leandrosly/s16-companion/imagens/componentes/D_NQ_NP_2X_614847-MLB119121963469_102026-F-modulo-dac-pcm5102-i2s-estereo-conversor-audio-digital-decal-sup.jpg

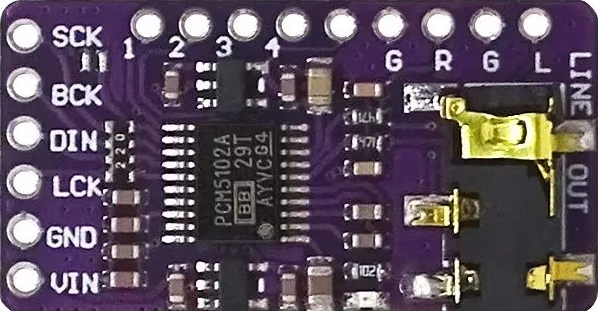
imagens/componentes/D_NQ_NP_2X_614847-MLB119121963469_102026-F-modulo-dac-pcm5102-i2s-estereo-conversor-audio-digital-decal-sup.jpg
