leandrosly/s16-companion/galeria_fotos/imagens/foto1.jpg

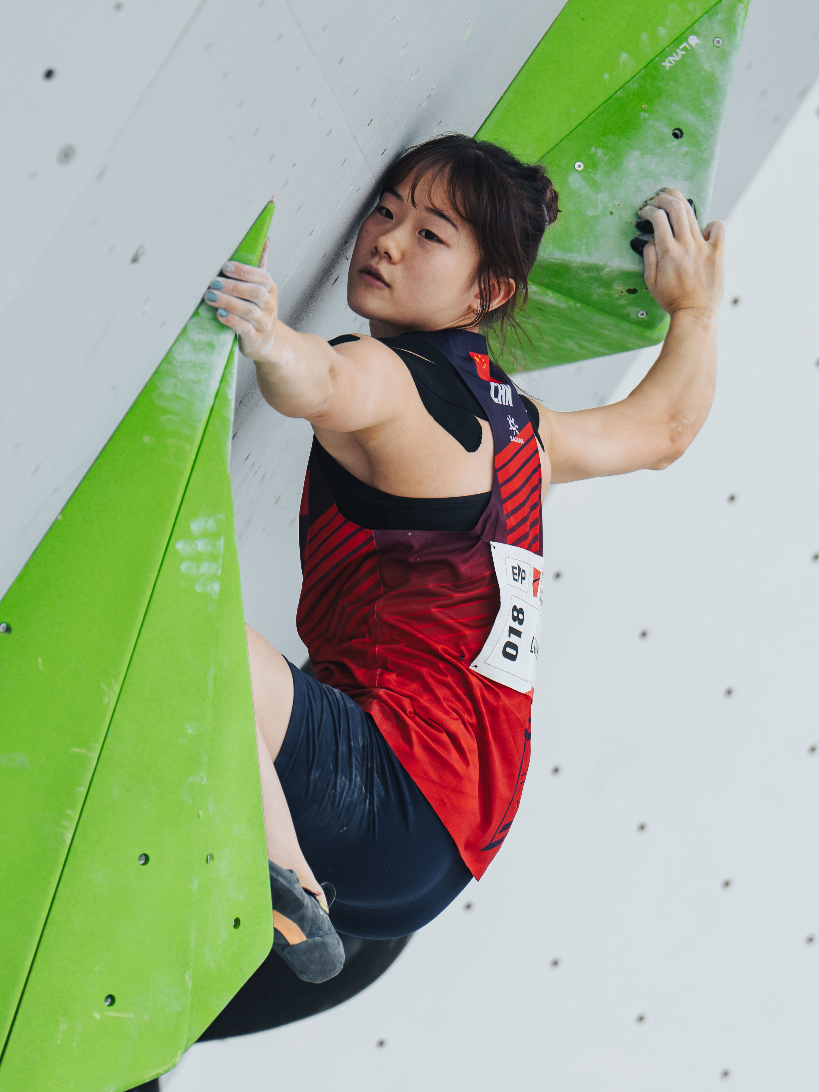
galeria_fotos/imagens/foto1.jpg
