leandrosly/s16-companion/galeria_fotos/imagens/foto2.jpg

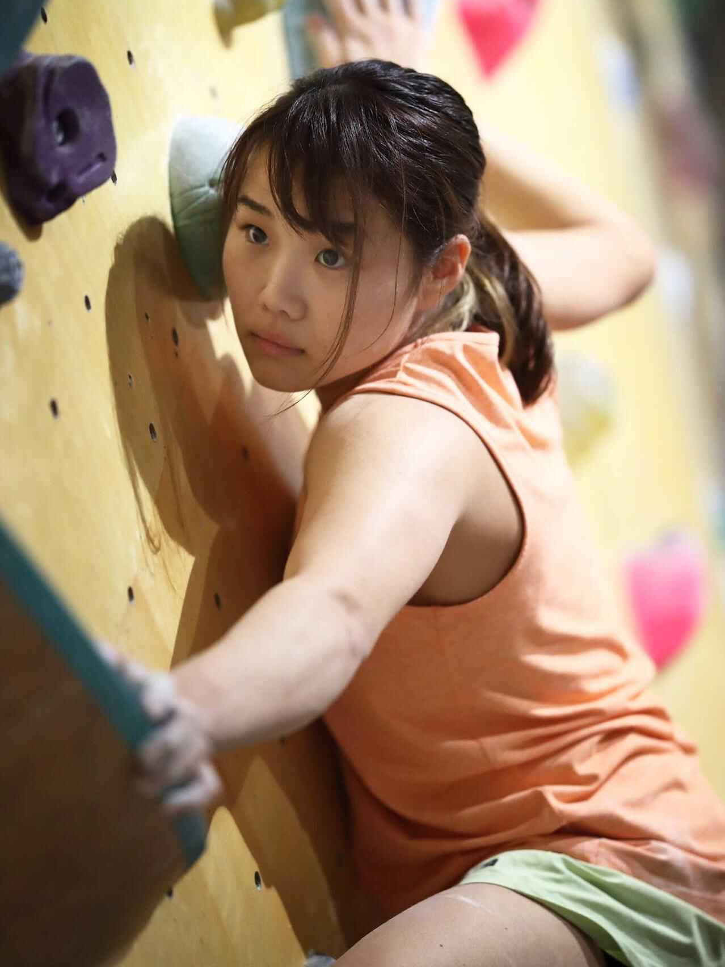
galeria_fotos/imagens/foto2.jpg
