leandrosly/s16-companion/galeria_fotos/imagens/foto3.jpg

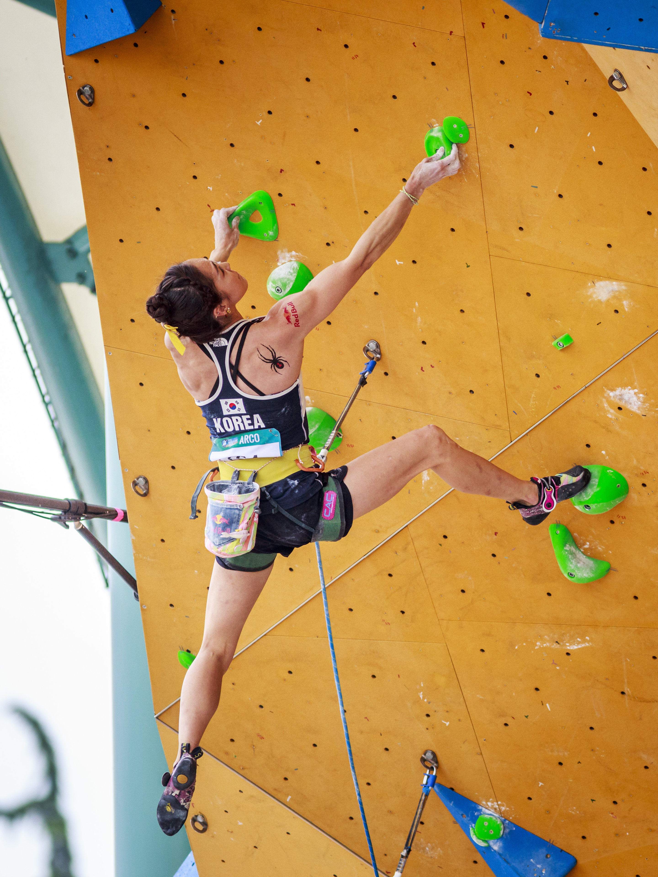
galeria_fotos/imagens/foto3.jpg
