leandrosly/s16-companion/galeria_fotos/imagens/foto4.jpg

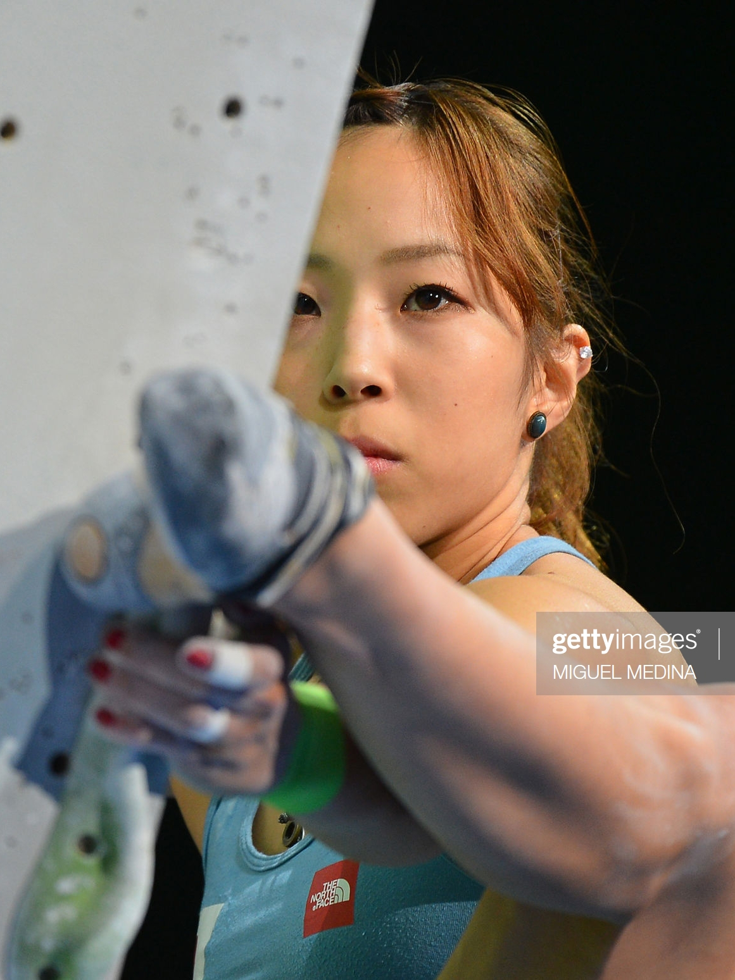
galeria_fotos/imagens/foto4.jpg
