leandrosly/s16-companion/galeria_fotos/imagens/foto5.jpg

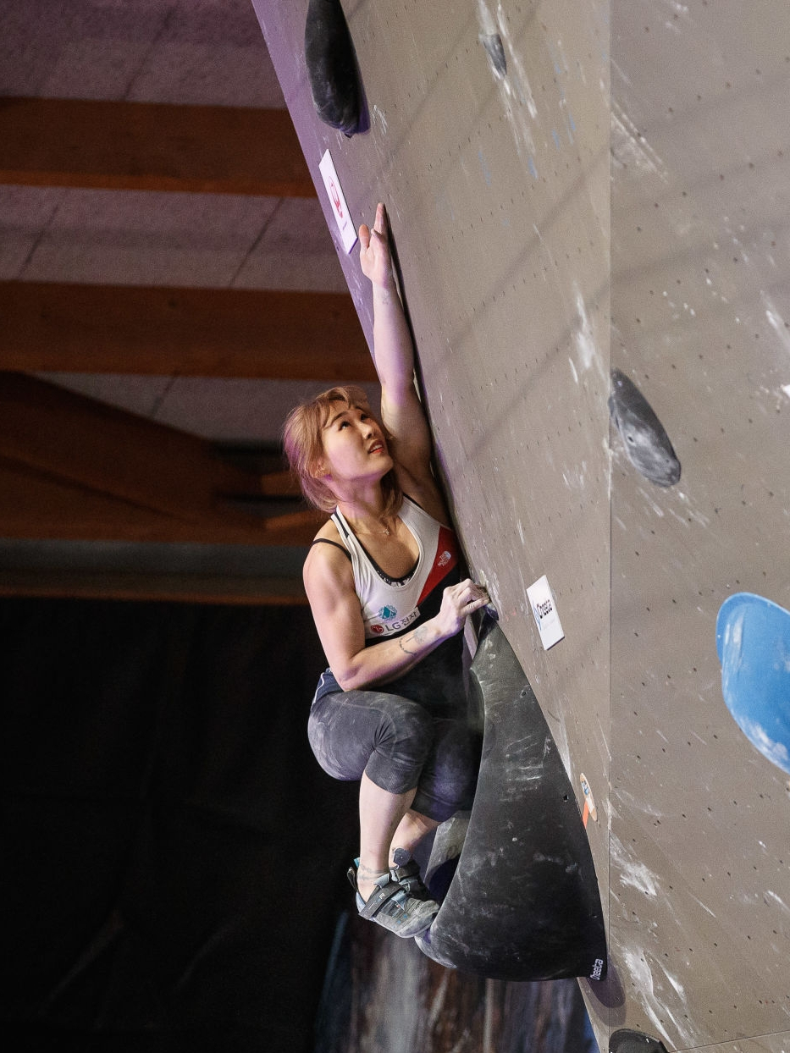
galeria_fotos/imagens/foto5.jpg
