leandrosly/s16-companion/galeria_fotos/imagens/foto6.jpg

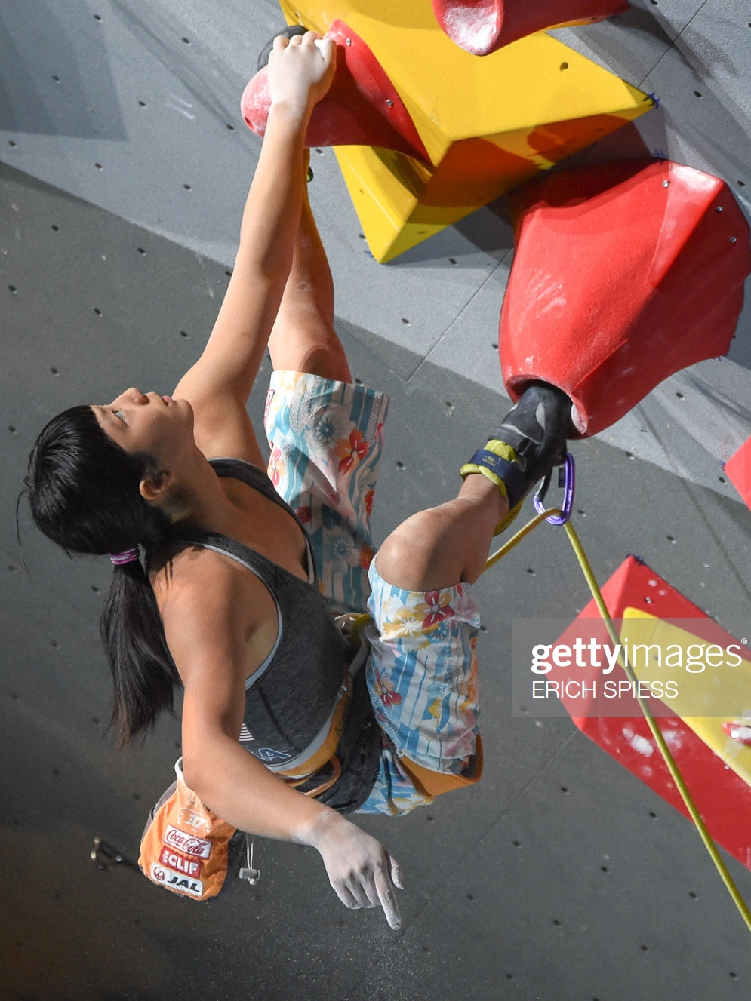
galeria_fotos/imagens/foto6.jpg
