leandrosly/s16-companion/imagens/fotos_placa_s16/PICA0004.jpg

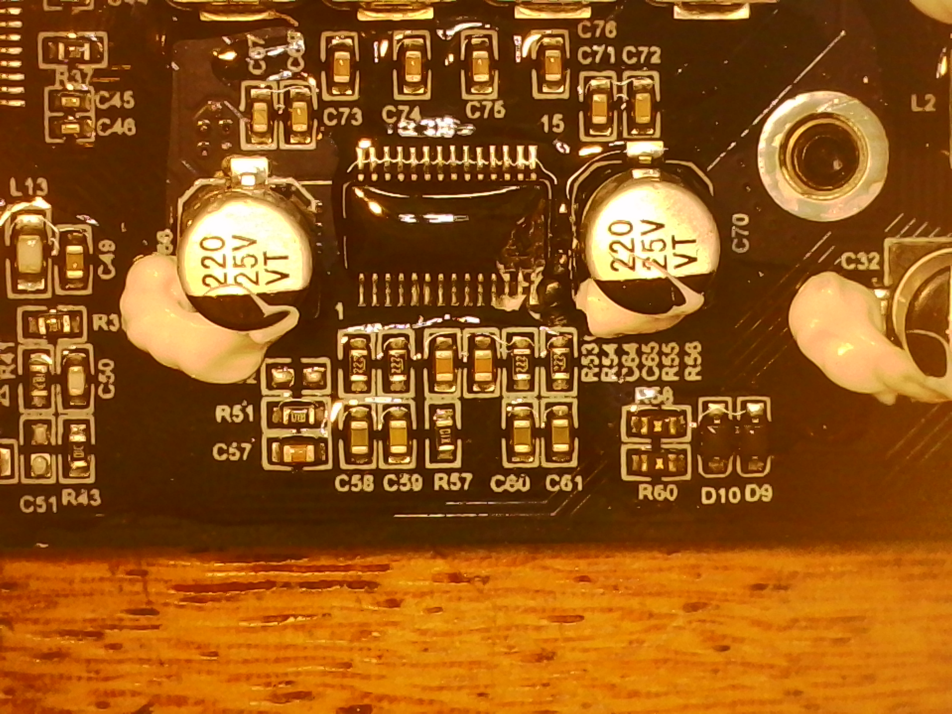
imagens/fotos_placa_s16/PICA0004.jpg
