leandrosly/s16-companion/imagens/fotos_placa_s16/PICA0006.jpg

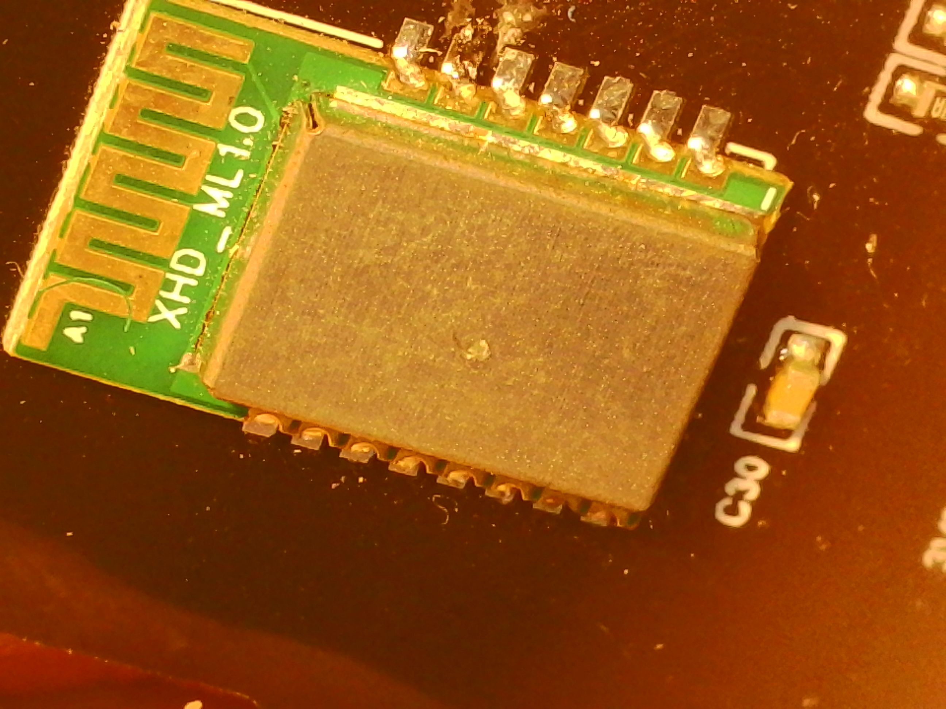
imagens/fotos_placa_s16/PICA0006.jpg
