leandrosly/s16-companion/imagens/fotos_placa_s16/PICA0007.jpg

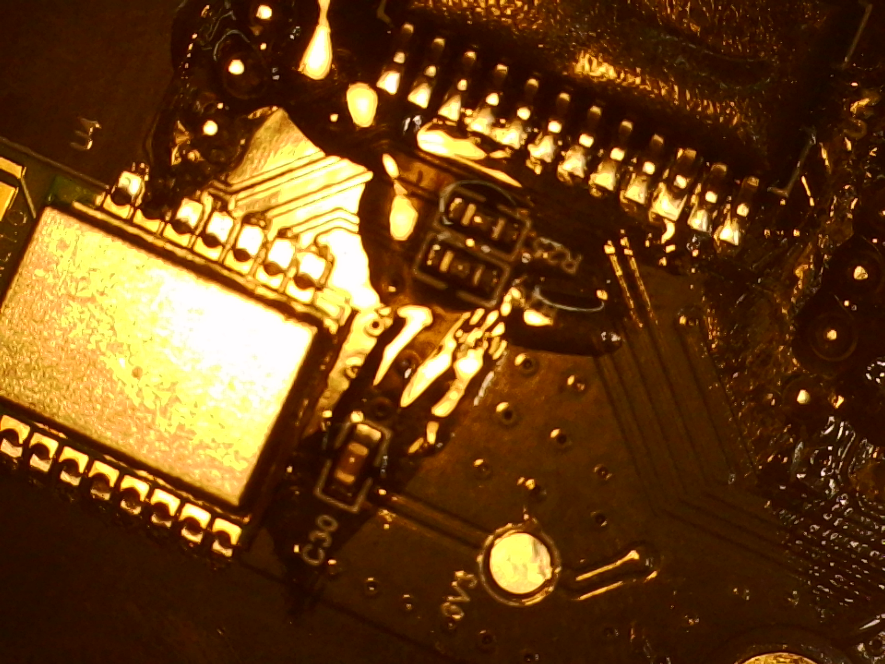
imagens/fotos_placa_s16/PICA0007.jpg
