leandrosly/s16-companion/imagens/fotos_placa_s16/PICA0008.jpg

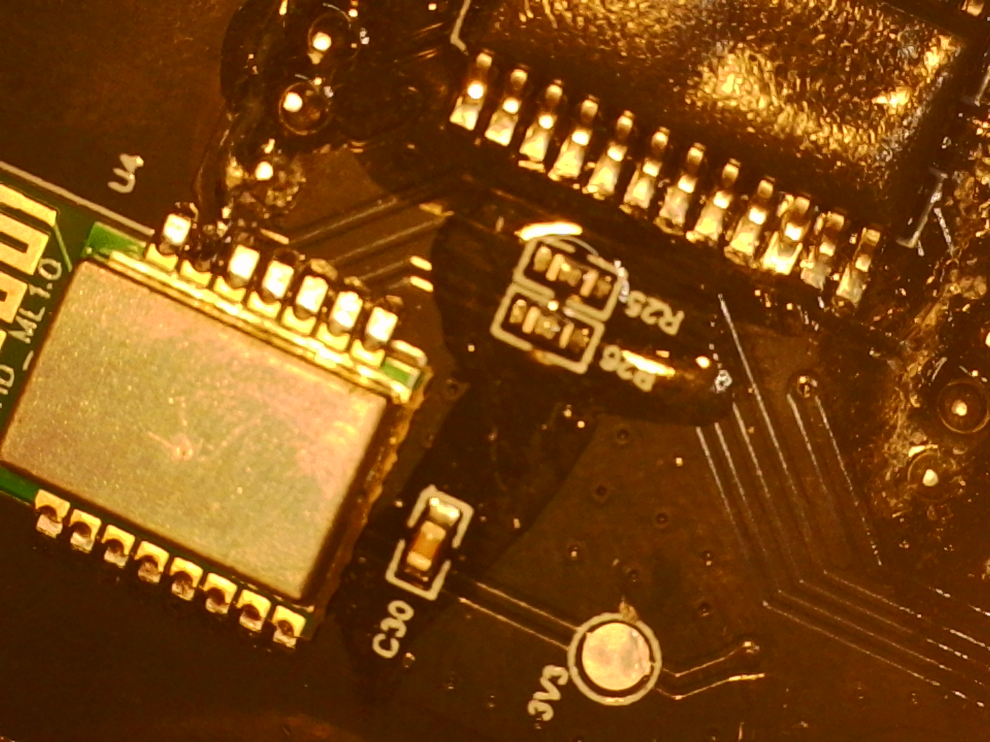
imagens/fotos_placa_s16/PICA0008.jpg
