leandrosly/s16-companion/imagens/componentes/D_NQ_NP_2X_686014-MLB119121433987_102026-F-modulo-dac-pcm5102-i2s-estereo-conversor-audio-digital.webp

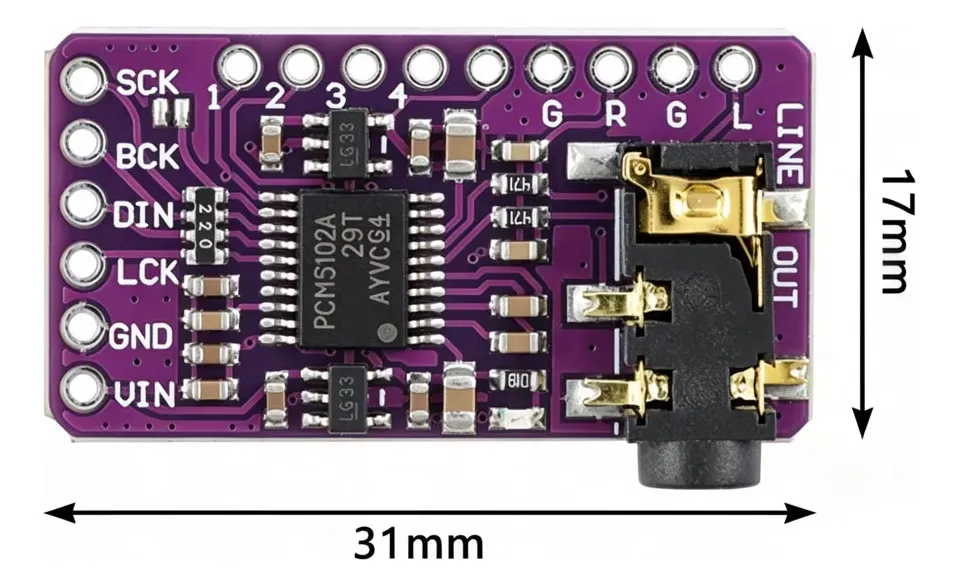
imagens/componentes/D_NQ_NP_2X_686014-MLB119121433987_102026-F-modulo-dac-pcm5102-i2s-estereo-conversor-audio-digital.webp
