leandrosly/s16-companion/imagens/componentes/D_NQ_NP_2X_740442-MLB73090768764_112023-F-par-de-modulos-rf-stx882-chip-super-heterodino-com-antenas-decal-inf.jpg

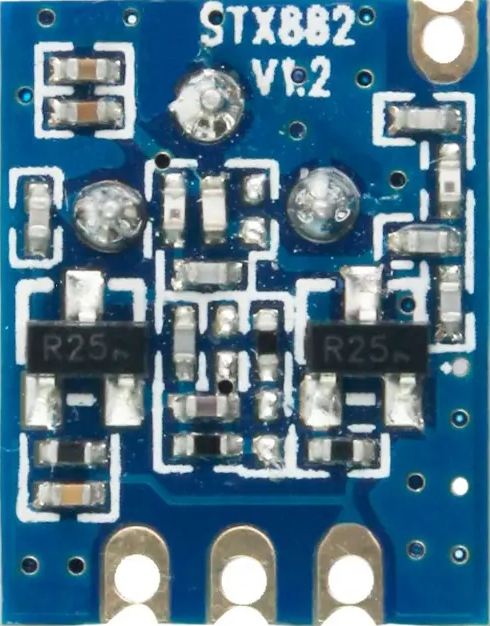
imagens/componentes/D_NQ_NP_2X_740442-MLB73090768764_112023-F-par-de-modulos-rf-stx882-chip-super-heterodino-com-antenas-decal-inf.jpg
