leandrosly/s16-companion/imagens/componentes/esp32-c3-super-mini-com-wifi-e-bluetooth-com-usb-c-decal-sup-decal-inf.jpg

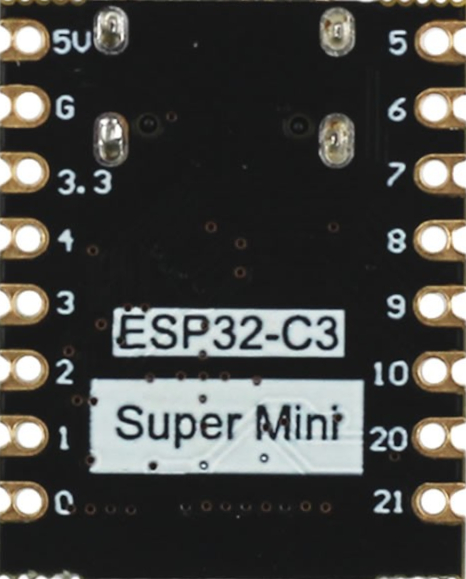
imagens/componentes/esp32-c3-super-mini-com-wifi-e-bluetooth-com-usb-c-decal-sup-decal-inf.jpg
