leandrosly/s16-companion/3d_case/Suporte.3mf

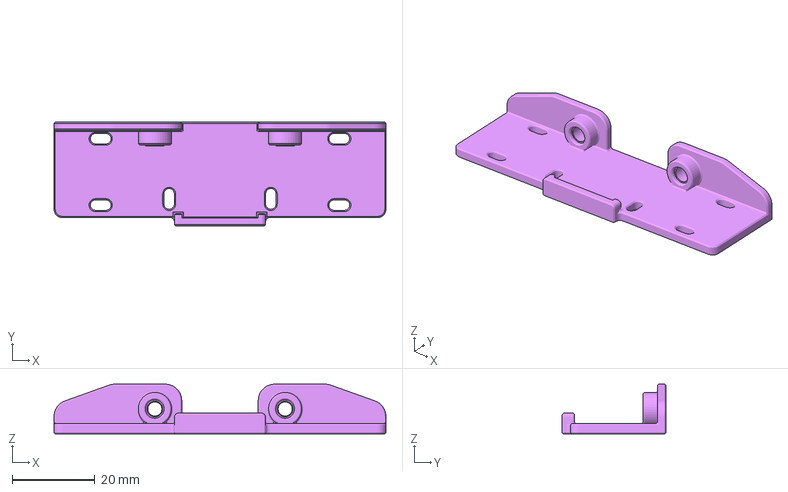
[picture p26: CAD file, 2026-11-10]
3d_case/Suporte.3mf
80.0 x 25.0 x 12.0 mm
