leandrosly/s16-companion/3d_case/Suporte ESP32 C3 no S16.step

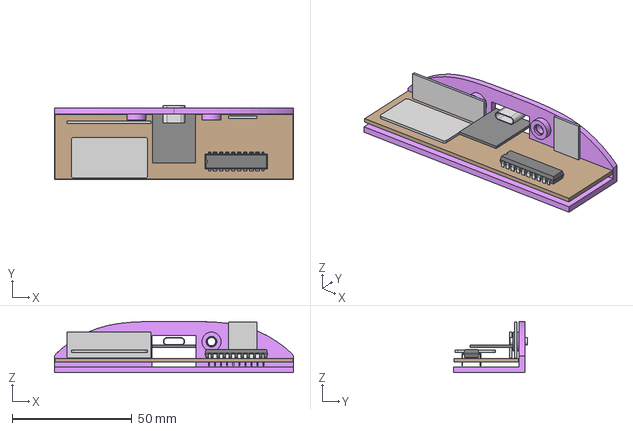
[picture p27: CAD file, 2026-11-10]
3d_case/Suporte ESP32 C3 no S16.step
100.0 x 31.0 x 21.5 mm
