leandrosly/s16-companion/3d_case/Espaço interno.3mf

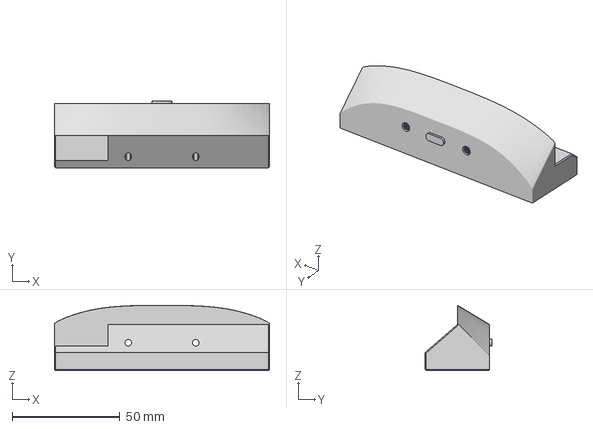
[picture p28: CAD file, 2026-11-10]
3d_case/Espaço interno.3mf
100.0 x 31.0 x 30.4 mm
