leandrosly/s16-companion/3d_case/S16 Companion.3mf

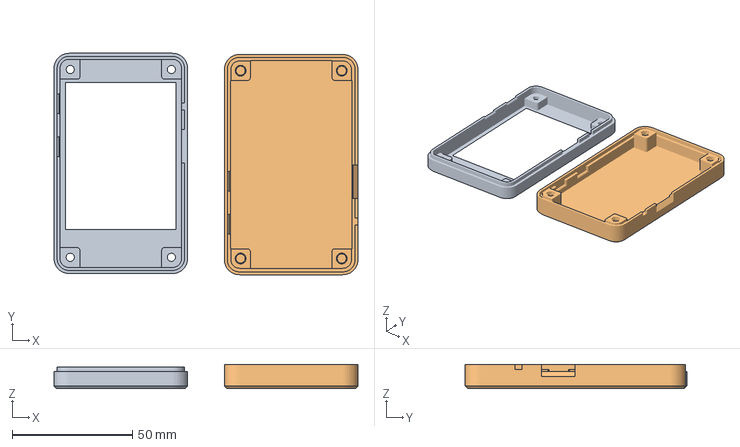
[picture p29: CAD file, 2026-10-17]
3d_case/S16 Companion.3mf
126.3 x 92.0 x 10.0 mm
