leandrosly/s16-companion/(list of files, cad)

Other CAD files:
3d_case/Suporte ESP32 C3 no S16 com pcb e módulos.3mf
3d_case/Suporte ESP32 C3 no S16.3mf
3d_case/Suporte ESP32 C3 no S16.f3d
