leandrosly/s16-companion/prints/print_001.bmp

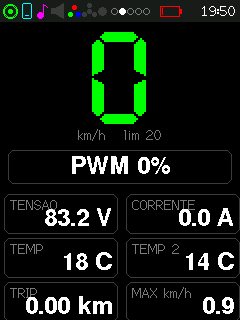
prints/print_001.bmp
