leandrosly/s16-companion/prints/print_002.bmp

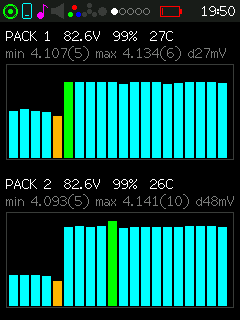
prints/print_002.bmp
