leandrosly/s16-companion/prints/print_004.bmp

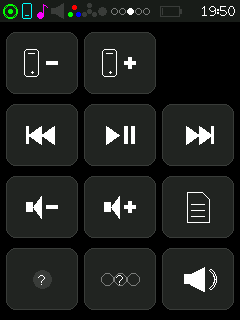
prints/print_004.bmp
