leandrosly/s16-companion/prints/print_005.bmp

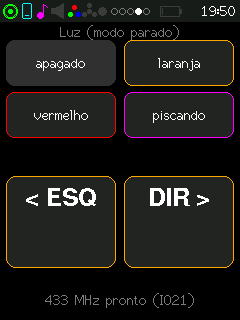
prints/print_005.bmp
