leandrosly/s16-companion/prints/print_006.bmp

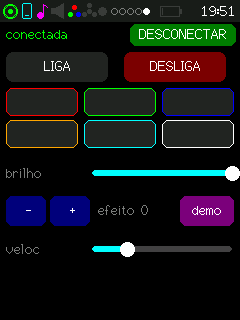
prints/print_006.bmp
