leandrosly/s16-companion/prints/print_007.bmp

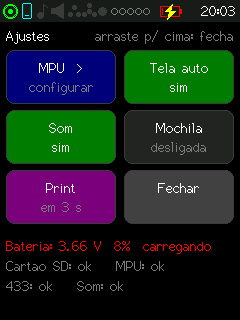
prints/print_007.bmp
