leandrosly/s16-companion/3d_case/Suporte ESP32 C3 no S16.pdf

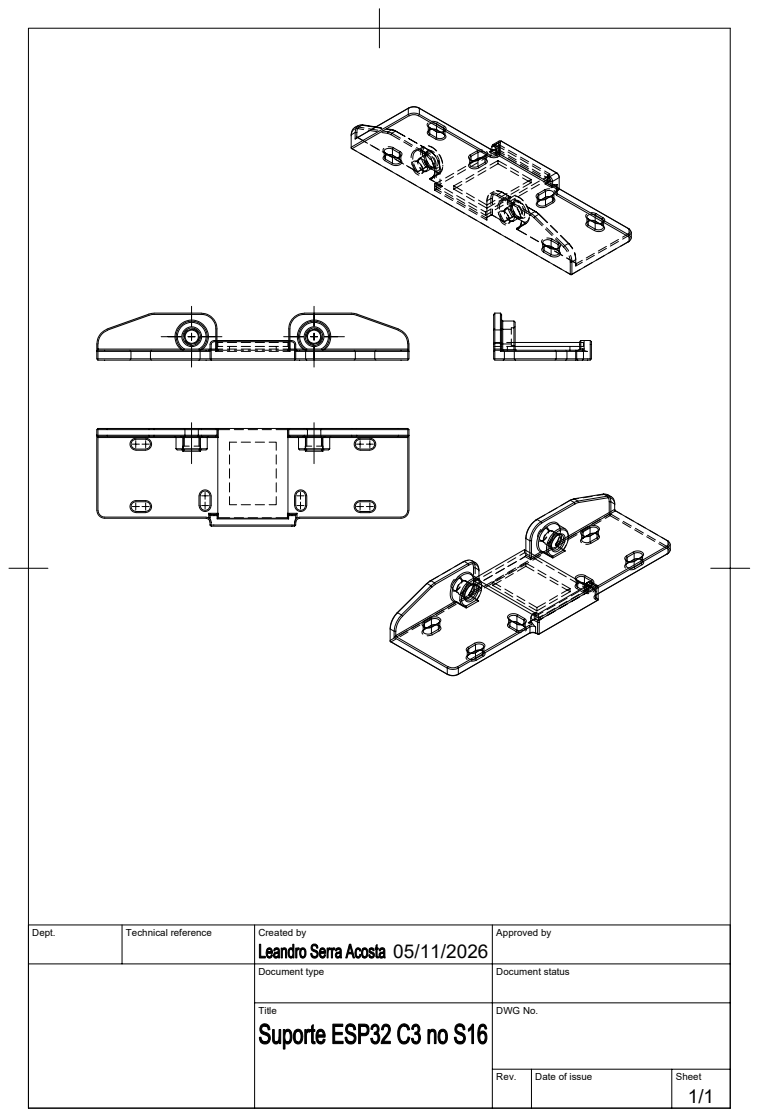
[picture p36: page 1]
Dept.; Technical reference; Created by; Approved by; Document type; Document status; Title; DWG No.; Rev.; Date of issue; Sheet
