leandrosly/s16-companion/pcb_kicad/S16_placa.kicad_pcb

## KiCad design pcb_kicad/S16_placa.kicad_pcb (2026-11-11)

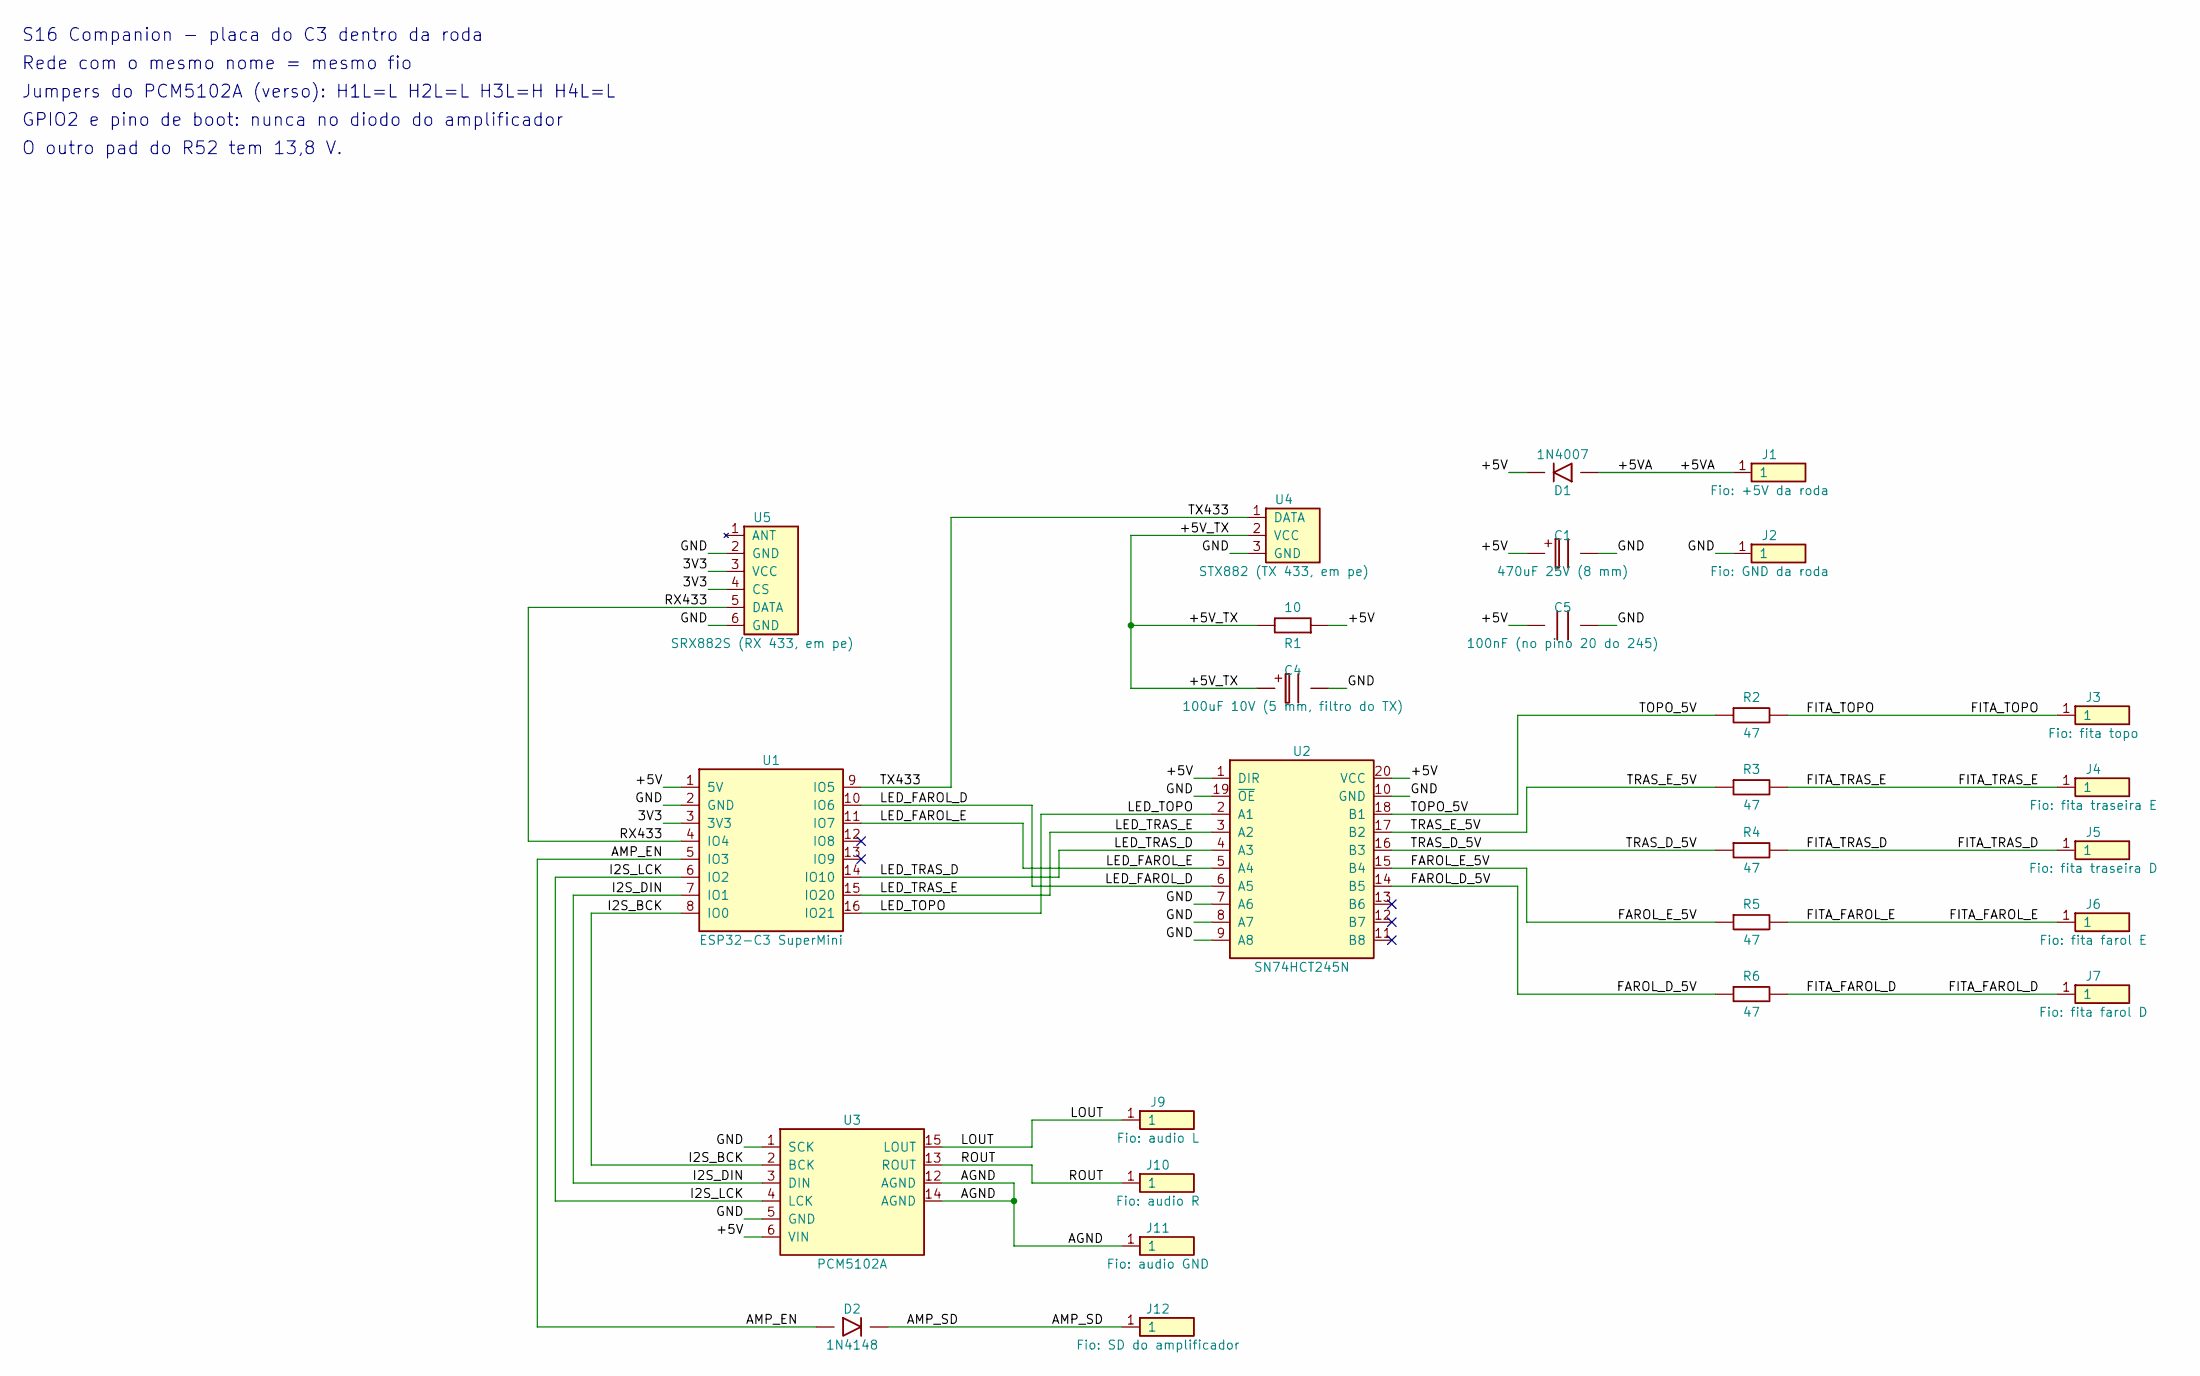
[picture p37: schematic S16_placa.kicad_sch, S16 Companion - placa do C3]

Parts:
C1: 470uF 25V (8 mm); CP_Radial_D8.0mm_P3.50mm
C4: 100uF 10V (5 mm, filtro do TX); CP_Radial_D5.0mm_P2.00mm
C5: 100nF (no pino 20 do 245); C_Disc_D5.0mm_W2.5mm_P5.00mm
D1: 1N4007; D_DO-41_SOD81_P7.62mm_Horizontal
D2: 1N4148; D_DO-35_SOD27_P7.62mm_Horizontal
J1: Fio: +5V da roda; TestPoint_THTPad_D2.5mm_Drill1.2mm
J2: Fio: GND da roda; TestPoint_THTPad_D2.5mm_Drill1.2mm
J3: Fio: fita topo; TestPoint_THTPad_D2.0mm_Drill1.0mm
J4: Fio: fita traseira E; TestPoint_THTPad_D2.0mm_Drill1.0mm
J5: Fio: fita traseira D; TestPoint_THTPad_D2.0mm_Drill1.0mm
J6: Fio: fita farol E; TestPoint_THTPad_D2.0mm_Drill1.0mm
J7: Fio: fita farol D; TestPoint_THTPad_D2.0mm_Drill1.0mm
J9: Fio: audio L; TestPoint_THTPad_D2.0mm_Drill1.0mm
J10: Fio: audio R; TestPoint_THTPad_D2.0mm_Drill1.0mm
J11: Fio: audio GND; TestPoint_THTPad_D2.0mm_Drill1.0mm
J12: Fio: SD do amplificador; TestPoint_THTPad_D2.0mm_Drill1.0mm
R1: 10; R_Axial_DIN0207_L6.3mm_D2.5mm_P7.62mm_Horizontal
R2, R3, R4, R5, R6: 47; R_Axial_DIN0207_L6.3mm_D2.5mm_P2.54mm_Vertical
U1: ESP32-C3 SuperMini; ESP32-C3_SuperMini
U2: SN74HCT245N; DIP-20_W7.62mm
U3: PCM5102A; PCM5102A_Modulo
U4: STX882 (TX 433, em pe); STX882_EmPe
U5: SRX882S (RX 433, em pe); SRX882S_EmPe

Connections:
/3V3: U1.3 (3V3), U5.3 (VCC), U5.4 (CS)
/+5V: C1.1, C5.1, D1.1, R1.1, U1.1 (5V), U2.1 (DIR), U2.20 (VCC), U3.6 (VIN)
/+5VA: D1.2, J1.1 (1_1)
/+5V_TX: C4.1, R1.2, U4.2 (VCC)
/AGND: J11.1 (1_1), U3.12 (AGND), U3.14 (AGND)
/AMP_EN: D2.2, U1.5 (IO3)
/AMP_SD: D2.1, J12.1 (1_1)
/FAROL_D_5V: R6.1, U2.14 (B5)
/FAROL_E_5V: R5.1, U2.15 (B4)
/FITA_FAROL_D: J7.1 (1_1), R6.2
/FITA_FAROL_E: J6.1 (1_1), R5.2
/FITA_TOPO: J3.1 (1_1), R2.2
/FITA_TRAS_D: J5.1 (1_1), R4.2
/FITA_TRAS_E: J4.1 (1_1), R3.2
/GND: C1.2, C4.2, C5.2, J2.1 (1_1), U1.2 (GND), U2.7 (A6), U2.8 (A7), U2.9 (A8), U2.10 (GND), U2.19 (~OE), U3.1 (SCK), U3.5 (GND), U4.3 (GND), U5.2 (GND), U5.6 (GND)
/I2S_BCK: U1.8 (IO0), U3.2 (BCK)
/I2S_DIN: U1.7 (IO1), U3.3 (DIN)
/I2S_LCK: U1.6 (IO2), U3.4 (LCK)
/LED_FAROL_D: U1.10 (IO6), U2.6 (A5)
/LED_FAROL_E: U1.11 (IO7), U2.5 (A4)
/LED_TOPO: U1.16 (IO21), U2.2 (A1)
/LED_TRAS_D: U1.14 (IO10), U2.4 (A3)
/LED_TRAS_E: U1.15 (IO20), U2.3 (A2)
/LOUT: J9.1 (1_1), U3.15 (LOUT)
/ROUT: J10.1 (1_1), U3.13 (ROUT)
/RX433: U1.4 (IO4), U5.5 (DATA)
/TOPO_5V: R2.1, U2.18 (B1)
/TRAS_D_5V: R4.1, U2.16 (B3)
/TRAS_E_5V: R3.1, U2.17 (B2)
/TX433: U1.9 (IO5), U4.1 (DATA)

Notes on the sheet:
Jumpers do PCM5102A (verso): H1L=L H2L=L H3L=H H4L=L
GPIO2 e pino de boot: nunca no diodo do amplificador
S16 Companion - placa do C3 dentro da roda
O outro pad do R52 tem 13,8 V.
Rede com o mesmo nome = mesmo fio

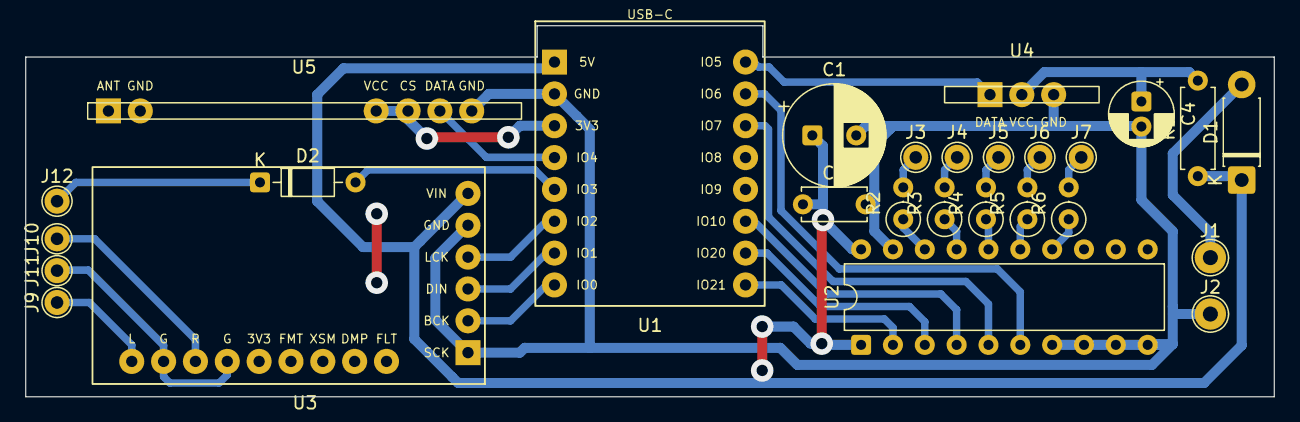
[picture p38: board S16_placa.kicad_pcb from above]

Board: 2 copper layers, 99.6 x 29.6 mm, 27 parts (0 on the bottom side), 30 nets.
