leandrosly/s16-companion/esquema_placa/projeto_kicad/projeto_kicad.kicad_sch

## KiCad design esquema_placa/projeto_kicad/projeto_kicad.kicad_sch (2026-11-10)

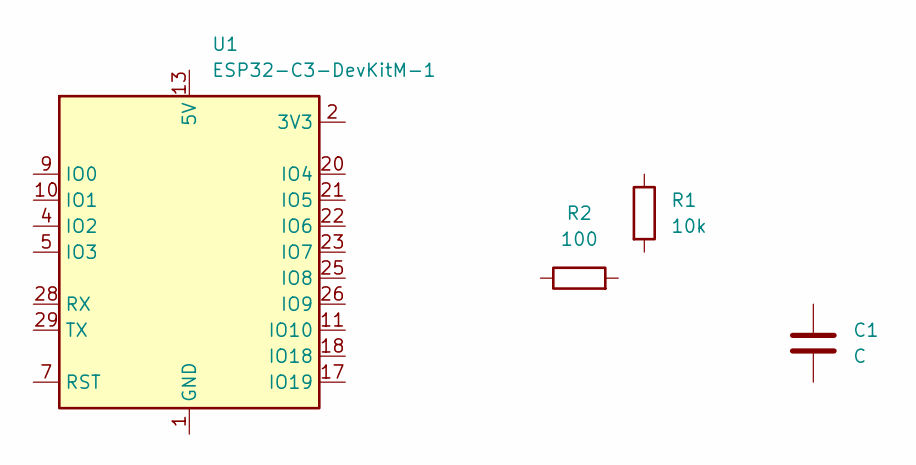
[picture p39: schematic projeto_kicad.kicad_sch]

Parts:
C1: C
R1: 10k
R2: 100
U1: ESP32-C3-DevKitM-1

Connections:
unnamed: U1.1 (GND), U1.6 (GND), U1.8 (GND), U1.12 (GND), U1.15 (GND), U1.16 (GND), U1.19 (GND), U1.24 (GND), U1.27 (GND), U1.30 (GND)
unnamed: U1.2 (3V3), U1.3 (3V3)
unnamed: U1.13 (5V), U1.14 (5V)
