leandrosly/s16-companion/app_android/app/src/main/java/Telas.kt

package systems.leandro.s16

// Telas do app (Jetpack Compose): barra com a conexao no topo e as paginas embaixo, que trocam tocando
// nos botoes ou arrastando para o lado:
//   com o C3:              Roda, Piscas, Fitas, Buzina, Sons
//   direto na roda:        Roda, Sons
//   sem conexao:           Sons (com a simulacao de velocidade)

import androidx.compose.animation.core.RepeatMode
import androidx.compose.animation.core.animateFloat
import androidx.compose.animation.core.infiniteRepeatable
import androidx.compose.animation.core.rememberInfiniteTransition
import androidx.compose.animation.core.tween
import androidx.compose.foundation.Canvas
import androidx.compose.foundation.background
import androidx.compose.foundation.border
import androidx.compose.foundation.clickable
import androidx.compose.foundation.gestures.detectTapGestures
import androidx.compose.foundation.layout.Spacer
import androidx.compose.foundation.layout.Arrangement
import androidx.compose.foundation.layout.Box
import androidx.compose.foundation.layout.PaddingValues
import androidx.compose.foundation.pager.HorizontalPager
import androidx.compose.foundation.pager.rememberPagerState
import androidx.compose.foundation.layout.Column
import androidx.compose.foundation.layout.ColumnScope
import androidx.compose.foundation.layout.Row
import androidx.compose.foundation.layout.fillMaxSize
import androidx.compose.foundation.layout.fillMaxWidth
import androidx.compose.foundation.layout.height
import androidx.compose.foundation.layout.padding
import androidx.compose.foundation.layout.safeDrawingPadding
import androidx.compose.foundation.layout.size
import androidx.compose.foundation.rememberScrollState
import androidx.compose.foundation.shape.CircleShape
import androidx.compose.foundation.shape.RoundedCornerShape
import androidx.compose.foundation.verticalScroll
import androidx.compose.material3.Button
import androidx.compose.material3.ButtonDefaults
import androidx.compose.material3.Card
import androidx.compose.material3.CardDefaults
import androidx.compose.material3.DropdownMenu
import androidx.compose.material3.DropdownMenuItem
import androidx.compose.material3.MaterialTheme
import androidx.compose.material3.OutlinedButton
import androidx.compose.material3.Slider
import androidx.compose.material3.Surface
import androidx.compose.material3.Switch
import androidx.compose.material3.Text
import androidx.compose.material3.darkColorScheme
import androidx.compose.runtime.Composable
import androidx.compose.runtime.LaunchedEffect
import androidx.compose.runtime.collectAsState
import androidx.compose.runtime.getValue
import androidx.compose.runtime.mutableFloatStateOf
import androidx.compose.runtime.mutableIntStateOf
import androidx.compose.runtime.mutableStateOf
import androidx.compose.runtime.remember
import androidx.compose.runtime.rememberUpdatedState
import androidx.compose.runtime.rememberCoroutineScope
import androidx.compose.runtime.saveable.rememberSaveable
import androidx.compose.runtime.setValue
import androidx.compose.ui.Alignment
import androidx.compose.ui.Modifier
import androidx.compose.ui.draw.alpha
import androidx.compose.ui.draw.clip
import androidx.compose.ui.geometry.Offset
import androidx.compose.ui.graphics.Path
import androidx.compose.ui.graphics.StrokeCap
import androidx.compose.ui.graphics.StrokeJoin
import androidx.compose.ui.graphics.drawscope.Stroke
import androidx.compose.ui.graphics.Color
import androidx.compose.ui.input.pointer.pointerInput
import androidx.compose.ui.platform.LocalContext
import androidx.compose.ui.text.font.FontWeight
import androidx.compose.ui.unit.dp
import androidx.compose.ui.unit.sp
import androidx.compose.ui.window.Dialog
import kotlinx.coroutines.launch
import kotlin.math.roundToInt

// ---------------- cores ----------------
private val Laranja = Color(0xFFF2A23A)
private val Fundo = Color(0xFF14171B)
private val Painel = Color(0xFF1D2126)
private val Texto = Color(0xFFE5E8EC)
private val Apagado = Color(0xFF8D97A3)
private val Vermelho = Color(0xFFFF5B4B)

private val esquema = darkColorScheme(
    primary = Laranja, onPrimary = Color(0xFF1B1200),
    secondary = Color(0xFF4FC3CC),
    background = Fundo, onBackground = Texto,
    surface = Painel, onSurface = Texto,
)

// mesma paleta do C3 (LED_PAL no ponte_c3.ino), na mesma ordem
private val PALETA = listOf(
    Color(255, 0, 0), Color(255, 90, 0), Color(255, 200, 0), Color(0, 255, 0),
    Color(0, 255, 200), Color(0, 0, 255), Color(0x4E, 0, 0x8F), Color(200, 200, 200),
)
private val NOMES_COR = listOf("vermelho", "laranja", "amarelo", "verde", "ciano", "azul", "violeta", "branco")
private val MODOS_FITA = listOf("Apagadas", "Cor fixa", "Respirando", "Arco-íris", "Automático")
private val LUZES = listOf("Apagadas", "Laranja", "Vermelhas", "Piscando")

// buzina externa: mesmos codigos do display (BX_CMD)
private val BUZINA = listOf(
    "Volume −" to 0xCC, "Volume +" to 0x99,
    "◀ Som" to 0x66, "Som ▶" to 0xFF,
    "Alarme liga" to 0x55, "Alarme desliga" to 0x33,
)

// ---------------- estrutura ----------------
@Composable
fun App(
    link: C3Link,
    macSalvo: String?,
    temPermissao: Boolean,
    btLigado: Boolean,
    pedirPermissao: () -> Unit,
    salvarMac: (String) -> Unit,
) {
    MaterialTheme(colorScheme = esquema) {
        Surface(Modifier.fillMaxSize(), color = Fundo) {
            Column(
                Modifier.fillMaxSize().safeDrawingPadding().padding(horizontal = 16.dp, vertical = 12.dp),
                verticalArrangement = Arrangement.spacedBy(12.dp),
            ) {
                if (!temPermissao || !btLigado) Text("S16 Companion", fontSize = 22.sp, fontWeight = FontWeight.Bold, color = Texto)
                when {
                    !temPermissao -> Aviso("O app precisa da permissão de Bluetooth para achar o C3 na roda.", "Permitir", pedirPermissao)
                    !btLigado -> Aviso("O Bluetooth está desligado. Ligue e volte para o app.", null) {}
                    else -> {
                        BarraTopo(link, macSalvo, salvarMac)
                        Principal(link)                          // (dentro da Column: ocupa o resto da tela)
                    }
                }
            }
        }
    }
}

@Composable
private fun ColumnScope.Principal(link: C3Link) {
    val con by link.conexao.collectAsState()
    val est by link.estado.collectAsState()
    val direto by link.direto.collectAsState()

    val comC3 = (con == Conexao.CONECTADO && est.recebido) || con == Conexao.DEMO
    val naRoda = con == Conexao.CONECTADO && direto
    val paginas = when {
        comC3 -> listOf("Roda", "Piscas", "Fitas", "Buzina", "Sons")
        naRoda -> listOf("Roda", "Sons")
        else -> listOf("Sons")
    }
    run {
        val pager = rememberPagerState(pageCount = { paginas.size })
        val escopo = rememberCoroutineScope()
        Row(horizontalArrangement = Arrangement.spacedBy(6.dp)) {
            paginas.forEachIndexed { i, nome ->
                Botao(nome, Modifier.weight(1f), selecionado = pager.currentPage == i) {
                    escopo.launch { pager.animateScrollToPage(i) }
                }
            }
        }
        HorizontalPager(
            state = pager,
            modifier = Modifier.fillMaxWidth().weight(1f),
            pageSpacing = 16.dp,
            verticalAlignment = Alignment.Top,
        ) { pagina ->
            Column(
                Modifier.fillMaxSize().verticalScroll(rememberScrollState()),
                verticalArrangement = Arrangement.spacedBy(12.dp),
            ) {
                when (paginas.getOrNull(pagina)) {
                    "Roda" -> TelaRoda(link, direto)
                    "Piscas" -> TelaPiscas(link, est)
                    "Fitas" -> TelaFitas(link, est)
                    "Buzina" -> TelaBuzina(link)
                    "Sons" -> TelaSons()
                }
            }
        }
    }
}

// ---------------- barra do topo: nome, estado da conexao e o botao do Bluetooth ----------------
// Icone do Bluetooth:  cinza = desconectado (toque: conecta)  ·  piscando = tentando (toque: para)
//                      colorido = conectado (toque: menu com detalhes, trocar e desconectar)
// O "+" ao lado (so desconectado) abre a lista para escolher o C3 ou a roda.
@Composable
private fun BarraTopo(link: C3Link, macSalvo: String?, salvarMac: (String) -> Unit) {
    val con by link.conexao.collectAsState()
    val est by link.estado.collectAsState()
    val direto by link.direto.collectAsState()
    var lista by remember { mutableStateOf(false) }
    var menu by remember { mutableStateOf(false) }
    val tentando = con == Conexao.CONECTANDO || (con == Conexao.DESCONECTADO && link.querendoConexao)

    val estado = when {
        con == Conexao.DEMO -> "demonstração"
        con == Conexao.CONECTADO && direto -> "na roda (sem C3)"
        con == Conexao.CONECTADO && est.recebido -> if (est.radioOk) "conectado" else "conectado · rádio 433 com problema"
        con == Conexao.CONECTADO -> "esperando resposta..."
        tentando -> "conectando..."
        con == Conexao.PROCURANDO -> "procurando..."
        macSalvo == null -> "toque no + para achar a roda"
        else -> "desconectado"
    }
    val corEstado = if (con == Conexao.CONECTADO && est.recebido && !est.radioOk) Laranja else Apagado

    Row(Modifier.fillMaxWidth(), verticalAlignment = Alignment.CenterVertically) {
        Column(Modifier.weight(1f)) {
            Text("S16 Companion", fontSize = 22.sp, fontWeight = FontWeight.Bold, color = Texto, maxLines = 1)
            Text(estado, fontSize = 13.sp, color = corEstado, maxLines = 1)
        }
        if (con == Conexao.DESCONECTADO && !tentando || con == Conexao.PROCURANDO) {
            IconeRedondo(Modifier.padding(end = 8.dp), ativo = false, onClick = { lista = true }) { cor -> DesenhoMais(cor) }
        }
        Box {
            val alfa = if (tentando) {
                val pisca = rememberInfiniteTransition(label = "pisca")
                pisca.animateFloat(
                    initialValue = 1f, targetValue = 0.25f,
                    animationSpec = infiniteRepeatable(tween(600), RepeatMode.Reverse), label = "alfa",
                ).value
            } else 1f
            val ativo = con == Conexao.CONECTADO || con == Conexao.DEMO || tentando
            IconeRedondo(Modifier.alpha(alfa), ativo = ativo, onClick = {
                when {
                    con == Conexao.CONECTADO || con == Conexao.DEMO -> menu = true
                    tentando -> link.desconectar()                                // para de tentar
                    macSalvo != null -> link.conectar(macSalvo)
                    else -> lista = true
                }
            }) { cor -> DesenhoBluetooth(cor) }
            DropdownMenu(expanded = menu, onDismissRequest = { menu = false }) {
                val info = when {
                    con == Conexao.DEMO -> "Demonstração: nada é enviado de verdade."
                    direto -> "Direto na roda: dados e sons funcionam; piscas e fitas precisam do C3."
                    else -> "C3 · rádio 433 ${if (est.radioOk) "ok" else "com problema"} · apps no C3: ${est.apps}"
                }
                Text(info, Modifier.padding(horizontal = 16.dp, vertical = 8.dp), fontSize = 13.sp, color = Apagado)
                if (con == Conexao.DEMO) {
                    DropdownMenuItem(text = { Text("Sair da demonstração") }, onClick = { menu = false; link.sairDemo() })
                } else {
                    DropdownMenuItem(text = { Text("Trocar de roda / C3") }, onClick = { menu = false; link.desconectar(); lista = true })
                    DropdownMenuItem(text = { Text("Desconectar") }, onClick = { menu = false; link.desconectar() })
                }
            }
        }
    }
    if (lista) SeletorConexao(link, salvarMac) { lista = false }
}

/** Janela com a busca: lista o C3 e a roda que aparecerem. */
@Composable
private fun SeletorConexao(link: C3Link, salvarMac: (String) -> Unit, fechar: () -> Unit) {
    val achados by link.achados.collectAsState()
    val con by link.conexao.collectAsState()
    var buscou by remember { mutableStateOf(false) }
    LaunchedEffect(con) { if (!buscou && con == Conexao.DESCONECTADO) { buscou = true; link.procurar() } }
    val sair = { link.pararBusca(); fechar() }
    Dialog(onDismissRequest = sair) {
        Card(colors = CardDefaults.cardColors(containerColor = Painel), modifier = Modifier.fillMaxWidth()) {
            Column(Modifier.fillMaxWidth().padding(16.dp), verticalArrangement = Arrangement.spacedBy(10.dp)) {
                Text("Conectar", fontSize = 20.sp, fontWeight = FontWeight.Bold, color = Texto)
                Text(
                    if (con == Conexao.PROCURANDO) "Procurando... ligue a roda: aparece o C3 (com o nome da roda, KS-...) ou a própria roda."
                    else "Busca parada.",
                    color = Apagado, fontSize = 13.sp,
                )
                achados.forEach { a ->
                    val ehRoda = a.mac.equals(MAC_RODA, ignoreCase = true)
                    Row(
                        Modifier.fillMaxWidth()
                            .clip(RoundedCornerShape(8.dp))
                            .background(Fundo)
                            .clickable { salvarMac(a.mac); link.conectar(a.mac); fechar() }
                            .padding(12.dp),
                        verticalAlignment = Alignment.CenterVertically,
                    ) {
                        Column(Modifier.weight(1f)) {
                            Text(a.nome, color = Texto)
                            Text(
                                a.mac + if (ehRoda) "  ·  a roda em si (direto, sem o C3)" else "",
                                fontSize = 12.sp, color = Apagado,
                            )
                        }
                        Text("${a.rssi} dBm", fontSize = 12.sp, color = Apagado)
                    }
                }
                Row(Modifier.fillMaxWidth(), verticalAlignment = Alignment.CenterVertically) {
                    Text(
                        "Demonstração",
                        Modifier.clickable { link.pararBusca(); link.entrarDemo(); fechar() }.padding(vertical = 8.dp),
                        color = Laranja, fontSize = 14.sp,
                    )
                    Spacer(Modifier.weight(1f))
                    if (con != Conexao.PROCURANDO) OutlinedButton(onClick = { link.procurar() }) { Text("Procurar de novo") }
                    else OutlinedButton(onClick = sair) { Text("Fechar") }
                }
            }
        }
    }
}

@Composable
private fun IconeRedondo(modifier: Modifier, ativo: Boolean, onClick: () -> Unit, desenho: @Composable (Color) -> Unit) {
    Box(
        modifier
            .size(44.dp)
            .clip(CircleShape)
            .background(if (ativo) Laranja else Painel)
            .clickable(onClick = onClick),
        contentAlignment = Alignment.Center,
    ) { desenho(if (ativo) Color(0xFF1B1200) else Apagado) }
}

/** O simbolo do Bluetooth (a runa), desenhado na mao para nao depender da biblioteca de icones. */
@Composable
private fun DesenhoBluetooth(cor: Color) {
    Canvas(Modifier.size(22.dp)) {
        val w = size.width; val h = size.height
        val p = Path().apply {
            moveTo(w * 0.28f, h * 0.30f)
            lineTo(w * 0.72f, h * 0.70f)
            lineTo(w * 0.50f, h * 0.90f)
            lineTo(w * 0.50f, h * 0.10f)
            lineTo(w * 0.72f, h * 0.30f)
            lineTo(w * 0.28f, h * 0.70f)
        }
        drawPath(p, cor, style = Stroke(width = w * 0.10f, cap = StrokeCap.Round, join = StrokeJoin.Round))
    }
}

@Composable
private fun DesenhoMais(cor: Color) {
    Canvas(Modifier.size(18.dp)) {
        val w = size.width; val h = size.height; val e = w * 0.12f
        drawLine(cor, Offset(w / 2, 0f), Offset(w / 2, h), strokeWidth = e, cap = StrokeCap.Round)
        drawLine(cor, Offset(0f, h / 2), Offset(w, h / 2), strokeWidth = e, cap = StrokeCap.Round)
    }
}

// ---------------- dados e comandos da roda ----------------
@Composable
private fun TelaRoda(link: C3Link, direto: Boolean) {
    val r by link.roda.collectAsState()
    val temDados = r.quando != 0L && System.currentTimeMillis() - r.quando < 3_000
    Secao("Roda") {
        if (!temDados) {
            Text("Sem dados da roda ainda.", color = Apagado)
        } else {
            Row(verticalAlignment = Alignment.Bottom) {
                Text("%.1f".format(r.velocidade), fontSize = 56.sp, fontWeight = FontWeight.Bold, color = Texto)
                Text("  km/h", fontSize = 18.sp, color = Apagado, modifier = Modifier.padding(bottom = 10.dp))
            }
            val corBat = when {
                r.bateria > 40 -> Texto
                r.bateria > 15 -> Laranja
                else -> Vermelho
            }
            val dados = listOf(
                // (o "%" da bateria fica FORA do format: dentro dele, "% ·" e lido como codigo de formatacao)
                Triple("Bateria", "${r.bateria}%" + (if (r.bateriaPeloBms) "" else " (≈)") + " · " + "%.1f V".format(r.tensao), corBat),
                Triple("Corrente", "%.1f A".format(r.corrente), Texto),
                Triple("Temperatura", "%.0f °C".format(r.temperatura), Texto),
                Triple("PWM", if (r.pwm >= 0) "${r.pwm}%" else "—", if (r.pwm >= 80) Vermelho else Texto),
                Triple("Viagem", "%.1f km".format(r.tripKm), Texto),
                Triple("Máxima", "%.1f km/h".format(r.maxima), Texto),
            )
            dados.chunked(2).forEach { par ->
                Row(Modifier.fillMaxWidth()) {
                    par.forEach { (rotulo, valor, cor) ->
                        Column(Modifier.weight(1f)) {
                            Text(rotulo, fontSize = 12.sp, color = Apagado)
                            Text(valor, fontSize = 18.sp, color = cor, fontWeight = FontWeight.SemiBold)
                        }
                    }
                }
            }
        }
    }
    Secao("Comandos da roda") {
        BotaoGrande("Buzina da roda", Modifier.fillMaxWidth(), selecionado = true) { link.enviarRoda(0x88) }
        Text("Volume dos alto-falantes", color = Apagado, fontSize = 13.sp)
        Row(horizontalArrangement = Arrangement.spacedBy(8.dp)) {
            Botao("Volume −", Modifier.weight(1f)) { link.enviarRoda(0x95, 0, 0xFF) }
            Botao("Volume +", Modifier.weight(1f)) { link.enviarRoda(0x95, 0xFF, 0) }
        }
        Text("Farol", color = Apagado, fontSize = 13.sp)
        Row(horizontalArrangement = Arrangement.spacedBy(8.dp)) {
            Botao("Liga", Modifier.weight(1f)) { link.enviarRoda(0x73, 0x12) }
            Botao("Desliga", Modifier.weight(1f)) { link.enviarRoda(0x73, 0x13) }
            Botao("Auto", Modifier.weight(1f)) { link.enviarRoda(0x73, 0x14) }
        }
    }
    Secao("Notificação") {
        val prefs = LocalContext.current.getSharedPreferences("s16", android.content.Context.MODE_PRIVATE)
        var qual by remember { mutableStateOf(prefs.getString(ConexaoService.PREF_BUZINA, "roda") ?: "roda") }
        Text("Botão \"Buzina\" da notificação toca:", color = Apagado, fontSize = 13.sp)
        Row(horizontalArrangement = Arrangement.spacedBy(8.dp)) {
            val opcoes = if (direto) listOf("roda" to "Da roda", "celular" to "Do celular")
                         else listOf("roda" to "Da roda", "externa" to "Externa", "celular" to "Do celular")
            opcoes.forEach { (chave, nome) ->
                Botao(nome, Modifier.weight(1f), selecionado = qual == chave) {
                    qual = chave
                    prefs.edit().putString(ConexaoService.PREF_BUZINA, chave).apply()
                }
            }
        }
        Text("A do celular é a última que você tocou na página Sons. A notificação mantém a conexão mesmo com o app fechado. Para encerrar, use \"Desconectar\".",
            color = Apagado, fontSize = 13.sp)
    }
}

// ---------------- piscas e lanternas ----------------
@Composable
private fun TelaPiscas(link: C3Link, est: EstadoC3) {
    Secao("Piscas") {
        Row(horizontalArrangement = Arrangement.spacedBy(8.dp)) {
            BotaoGrande("◀  Esquerda", Modifier.weight(1f), est.pisca == 1) { link.enviar(Cmd.PISCA, 1) }
            BotaoGrande("Direita  ▶", Modifier.weight(1f), est.pisca == 2) { link.enviar(Cmd.PISCA, 2) }
        }
        Text("Toque de novo no mesmo lado para desligar.", color = Apagado, fontSize = 13.sp)
    }
    Secao("Lanternas com a roda parada") {
        LUZES.chunked(2).forEachIndexed { linha, par ->
            Row(horizontalArrangement = Arrangement.spacedBy(8.dp)) {
                par.forEachIndexed { j, nome ->
                    val i = linha * 2 + j
                    Botao(nome, Modifier.weight(1f), selecionado = est.luzBase == i) { link.enviar(Cmd.LUZBASE, i) }
                }
            }
        }
    }
    Secao("Freio") {
        LinhaSwitch("Freio automático (pela desaceleração)", est.freioAuto) {
            link.enviar(Cmd.FREIOAUTO, if (it) 1 else 0)
        }
        Row(verticalAlignment = Alignment.CenterVertically) {
            Text(
                if (est.freio) "FREANDO" else "Luz de freio apagada",
                Modifier.weight(1f),
                color = if (est.freio) Vermelho else Apagado,
                fontWeight = if (est.freio) FontWeight.Bold else FontWeight.Normal,
            )
            OutlinedButton(onClick = { link.enviar(Cmd.FREIOTESTE, 1) }) { Text("Testar") }
        }
    }
}

// ---------------- fitas de LED ----------------
@Composable
private fun TelaFitas(link: C3Link, est: EstadoC3) {
    Secao("Efeito") {
        MODOS_FITA.chunked(2).forEachIndexed { linha, par ->
            Row(horizontalArrangement = Arrangement.spacedBy(8.dp)) {
                par.forEachIndexed { j, nome ->
                    val i = linha * 2 + j
                    Botao(nome, Modifier.weight(1f), selecionado = est.ledModo == i) { link.enviar(Cmd.LED_MODO, i) }
                }
                if (par.size == 1) Box(Modifier.weight(1f))
            }
        }
        Text("Automático: respira com a roda parada e vira arco-íris andando.", color = Apagado, fontSize = 13.sp)
    }

    Secao("Cor") {
        PALETA.chunked(4).forEachIndexed { linha, cores ->
            Row(horizontalArrangement = Arrangement.spacedBy(14.dp)) {
                cores.forEachIndexed { j, cor ->
                    val i = linha * 4 + j
                    val sel = est.ledCor == i
                    Box(
                        Modifier.size(44.dp)
                            .clip(CircleShape)
                            .background(cor)
                            .border(if (sel) 3.dp else 1.dp, if (sel) Texto else Apagado, CircleShape)
                            .clickable { link.enviar(Cmd.LED_COR, i) },
                    )
                }
            }
        }
        val nomeCor = if (est.ledCor in NOMES_COR.indices) NOMES_COR[est.ledCor] else "personalizada"
        Text("Cor atual: $nomeCor", color = Apagado, fontSize = 13.sp)
    }

    Secao("Brilho") {
        // o slider mexe localmente e so manda ao soltar (cada envio grava na flash do C3)
        var brilho by remember { mutableFloatStateOf(est.ledBrilho.toFloat()) }
        var arrastando by remember { mutableStateOf(false) }
        LaunchedEffect(est.ledBrilho) { if (!arrastando) brilho = est.ledBrilho.toFloat() }
        Text("${brilho.roundToInt()}% (máximo 60%)", color = Texto)
        Slider(
            value = brilho,
            onValueChange = { arrastando = true; brilho = it },
            valueRange = 0f..60f,
            steps = 11,                                          // de 5 em 5
            onValueChangeFinished = { arrastando = false; link.enviar(Cmd.LED_BRILHO, brilho.roundToInt()) },
        )
    }

    Secao("Junto com as luzes") {
        LinhaSwitch("Piscas nas fitas", est.ledPiscas) {
            link.enviar(Cmd.LED_FLAGS, (if (it) 1 else 0) or (if (est.ledFreio) 2 else 0))
        }
        LinhaSwitch("Freio nas fitas", est.ledFreio) {
            link.enviar(Cmd.LED_FLAGS, (if (est.ledPiscas) 1 else 0) or (if (it) 2 else 0))
        }
    }
}

// ---------------- buzina externa (433) ----------------
@Composable
private fun TelaBuzina(link: C3Link) {
    Secao("Buzina externa") {
        BotaoGrande("BUZINA", Modifier.fillMaxWidth(), selecionado = true) { link.enviar(Cmd.BUZEXT, 0xAA) }
        BUZINA.chunked(2).forEach { par ->
            Row(horizontalArrangement = Arrangement.spacedBy(8.dp)) {
                par.forEach { (nome, codigo) ->
                    Botao(nome, Modifier.weight(1f)) { link.enviar(Cmd.BUZEXT, codigo) }
                }
            }
        }
        Text("O som e o volume ficam guardados na própria buzina.", color = Apagado, fontSize = 13.sp)
    }
}

// ---------------- sons do motor e buzinas no celular ----------------
@Composable
private fun TelaSons() {
    val ctx = LocalContext.current
    Som.iniciar(ctx)
    val ligado by Som.ligado.collectAsState()
    val aj by Som.ajustes.collectAsState()
    val p by Som.painel.collectAsState()
    val alvo by Som.alvoSim.collectAsState()
    val auto by Som.autoSim.collectAsState()
    val def = MOTORES.firstOrNull { it.id == aj.motor } ?: MOTORES[0]

    Secao("Som do motor") {
        BotaoGrande(if (ligado) "Desligar motor" else "Ligar motor", Modifier.fillMaxWidth(), selecionado = ligado) {
            Som.alternar(ctx)
        }
        Row(Modifier.fillMaxWidth(), verticalAlignment = Alignment.Bottom) {
            Text("%.0f".format(p.velocidade), fontSize = 44.sp, fontWeight = FontWeight.Bold, color = Texto)
            Text("  km/h", fontSize = 16.sp, color = Apagado, modifier = Modifier.padding(bottom = 8.dp))
            Spacer(Modifier.weight(1f))
            val giro = if (def.rpm) "%.0f rpm · %dª".format(p.rpm, p.marcha + 1) else "%.0f%%".format(p.rpm)
            Text(giro, fontSize = 16.sp, color = Texto, modifier = Modifier.padding(bottom = 8.dp))
        }
        Text(
            if (p.daRoda) "Velocidade vindo da roda." else "Sem dados da roda: usando a simulação abaixo.",
            color = Apagado, fontSize = 13.sp,
        )
    }

    Secao("Motor") {
        MOTORES.chunked(2).forEach { par ->
            Row(horizontalArrangement = Arrangement.spacedBy(8.dp)) {
                par.forEach { m ->
                    Escolha(m.nome, m.sub, Modifier.weight(1f), m.id == aj.motor) { Som.ajustar(aj.copy(motor = m.id)) }
                }
                if (par.size == 1) Box(Modifier.weight(1f))
            }
        }
        Text(def.desc, color = Apagado, fontSize = 13.sp)
    }

    if (!p.daRoda || aj.simular) {
        Secao("Simulação") {
            Text("Velocidade: %.0f km/h".format(alvo), color = Texto)
            Slider(value = alvo, onValueChange = { Som.alvoSim.value = it }, valueRange = 0f..50f)
            Row(horizontalArrangement = Arrangement.spacedBy(8.dp)) {
                BotaoSegurar("Acelerar", Modifier.weight(1f), { Som.segurar(true, false) }, { Som.segurar(false, false) })
                BotaoSegurar("Frear", Modifier.weight(1f), { Som.segurar(false, true) }, { Som.segurar(false, false) })
            }
            LinhaSwitch("Passeio automático", auto) { Som.autoSim.value = it }
        }
    }

    Secao("Buzinas do celular") {
        val prefs = ctx.getSharedPreferences("s16", android.content.Context.MODE_PRIVATE)
        BUZINAS.chunked(2).forEach { par ->
            Row(horizontalArrangement = Arrangement.spacedBy(8.dp)) {
                par.forEach { b ->
                    BotaoSegurar(b.nome, Modifier.weight(1f), {
                        Som.apertaBuzina(ctx, b.chave)
                        prefs.edit().putString(ConexaoService.PREF_BUZINA_CEL, b.chave).apply()
                    }, { Som.soltaBuzina() })
                }
                if (par.size == 1) Box(Modifier.weight(1f))
            }
        }
        Text("Segure para buzinar: as longas tocam enquanto o dedo estiver em cima.", color = Apagado, fontSize = 13.sp)
    }

    Secao("Ajustes do som") {
        Text("Volume: ${(aj.volume * 100).roundToInt()}%", color = Texto)
        Slider(value = aj.volume, onValueChange = { Som.ajustar(aj.copy(volume = it)) }, valueRange = 0f..1f)
        Text("Timbre: " + (if (aj.timbre > 0) "+" else "") + "${aj.timbre.roundToInt()} dB (mais grave ↔ mais agudo)", color = Texto)
        Slider(value = aj.timbre, onValueChange = { Som.ajustar(aj.copy(timbre = it.roundToInt().toFloat())) }, valueRange = -12f..12f)
        Text("Reação ao acelerar: " + "%.1f×".format(aj.reacao), color = Texto)
        Slider(value = aj.reacao, onValueChange = { Som.ajustar(aj.copy(reacao = (it * 10).roundToInt() / 10f)) }, valueRange = 0.5f..3f)
        if (def.rpm && !def.cvt) LinhaSwitch("Trocar marchas", aj.marchas) { Som.ajustar(aj.copy(marchas = it)) }
        if (def.tipo == "banco") LinhaSwitch("Estouros no escapamento", aj.estouros) { Som.ajustar(aj.copy(estouros = it)) }
        LinhaSwitch("Pneu cantando nas freadas fortes", aj.pneu) { Som.ajustar(aj.copy(pneu = it)) }
        LinhaSwitch("Ligar o motor sozinho ao conectar", aj.ligarJunto) { Som.ajustar(aj.copy(ligarJunto = it)) }
        LinhaSwitch("Simular mesmo com a roda conectada", aj.simular) { Som.ajustar(aj.copy(simular = it)) }
        Text("O som segue tocando com a tela apagada e o celular no bolso (pela notificação).",
            color = Apagado, fontSize = 13.sp)
    }
}

@Composable
private fun Escolha(nome: String, sub: String, modifier: Modifier, selecionado: Boolean, onClick: () -> Unit) {
    val forma = RoundedCornerShape(12.dp)
    Column(
        modifier
            .clip(forma)
            .background(if (selecionado) Laranja else Fundo)
            .border(1.dp, if (selecionado) Laranja else Apagado, forma)
            .clickable(onClick = onClick)
            .padding(horizontal = 10.dp, vertical = 8.dp),
    ) {
        val cor = if (selecionado) Color(0xFF1B1200) else Texto
        Text(nome, color = cor, fontWeight = FontWeight.SemiBold, fontSize = 14.sp, maxLines = 1)
        Text(sub, color = if (selecionado) cor else Apagado, fontSize = 12.sp, maxLines = 1)
    }
}

/** Botao que age enquanto esta apertado (buzina, acelerar). */
@Composable
private fun BotaoSegurar(texto: String, modifier: Modifier = Modifier, aperta: () -> Unit, solta: () -> Unit) {
    var apertado by remember { mutableStateOf(false) }
    val ap by rememberUpdatedState(aperta)
    val so by rememberUpdatedState(solta)
    val forma = RoundedCornerShape(24.dp)
    Box(
        modifier
            .height(48.dp)
            .clip(forma)
            .background(if (apertado) Laranja else Fundo)
            .border(1.dp, if (apertado) Laranja else Apagado, forma)
            .pointerInput(Unit) {
                detectTapGestures(onPress = {
                    apertado = true
                    ap()
                    try { tryAwaitRelease() } finally { apertado = false; so() }
                })
            },
        contentAlignment = Alignment.Center,
    ) {
        Text(texto, color = if (apertado) Color(0xFF1B1200) else Texto, fontSize = 14.sp, maxLines = 1)
    }
}

// ---------------- pecas ----------------
@Composable
private fun Secao(titulo: String, conteudo: @Composable ColumnScope.() -> Unit) {
    Card(colors = CardDefaults.cardColors(containerColor = Painel), modifier = Modifier.fillMaxWidth()) {
        Column(Modifier.fillMaxWidth().padding(16.dp), verticalArrangement = Arrangement.spacedBy(10.dp)) {
            Text(
                titulo.uppercase(),
                fontSize = 12.sp, letterSpacing = 1.5.sp,
                color = Apagado, fontWeight = FontWeight.SemiBold,
            )
            conteudo()
        }
    }
}

@Composable
private fun Botao(texto: String, modifier: Modifier = Modifier, selecionado: Boolean = false, onClick: () -> Unit) {
    val pad = PaddingValues(horizontal = 6.dp, vertical = 10.dp)
    if (selecionado) Button(onClick = onClick, modifier = modifier, contentPadding = pad) { Text(texto, maxLines = 1) }
    else OutlinedButton(onClick = onClick, modifier = modifier, contentPadding = pad) { Text(texto, color = Texto, maxLines = 1) }
}

@Composable
private fun BotaoGrande(texto: String, modifier: Modifier = Modifier, selecionado: Boolean = false, onClick: () -> Unit) {
    val cores = if (selecionado) ButtonDefaults.buttonColors()
                else ButtonDefaults.buttonColors(containerColor = Fundo, contentColor = Texto)
    Button(onClick = onClick, modifier = modifier.height(64.dp), colors = cores) {
        Text(texto, fontSize = 18.sp, fontWeight = FontWeight.SemiBold)
    }
}

@Composable
private fun LinhaSwitch(texto: String, valor: Boolean, mudou: (Boolean) -> Unit) {
    Row(Modifier.fillMaxWidth(), verticalAlignment = Alignment.CenterVertically) {
        Text(texto, Modifier.weight(1f), color = Texto)
        Switch(checked = valor, onCheckedChange = mudou)
    }
}

@Composable
private fun Aviso(texto: String, botao: String?, acao: () -> Unit) {
    Secao("Atenção") {
        Text(texto, color = Texto)
        if (botao != null) Button(onClick = acao) { Text(botao) }
    }
}
