leandrosly/s16-companion/(commit log)

2026-10-02 Ajuste nas configurações da plada na IDE do arduino
2026-10-05 v4 bem avancado e galeria de testes
2026-10-05 cria pasta para patchs ninble e readme
2026-10-05 mudanca na galeria que nao lembro
2026-10-06 adiciona v5 e separa midia de 2 apps mas funcionando mais de 1 app na versao midia
2026-10-09 adiciona teste de desligamento da tela pela mpu
2026-10-09 resolve problema de dormir quando clica na tela
    [teste_tela_mpu.ino]
2026-10-09 adiciona tela de config
2026-10-09 corrige sensibilidade, adiciona botao padrao
    [teste_tela_mpu.ino]
2026-10-10 teste de comunicação com o modulo iflight funcionando ok via serial (e o resto todo)
2026-10-13 adiciona prints
2026-10-15 adiciona função de luz de freio na mochila e nos piscas
2026-10-15 corrige problema de precisar reconectar s16 controle quando desliga o display
2026-10-15 ajustes no readme para a realidade atual
2026-10-15 primeiro teste do case em PET
2026-10-16 adiciona variavel para girar a tela
2026-10-16 nova versão temporária da case
2026-10-17 atualiza case 3d
2026-10-22 adiciona medidor 433 para teste e calibração da bateria
2026-10-26 adiciona ponte_c3 para ficar interna no mono
2026-10-27 adiciona codigo para controle do 433 via display
2026-10-31 adiciona modo para contar leds das fitas
2026-10-31 adiciona controle dos leds no ponte_c3
2026-11-01 tela para configurar os leds no display
2026-11-04 adiciona app android e laboratório de sons
2026-11-10 novo suporte 3d para pcb
2026-11-10 adiciona pasta de imagens
2026-11-10 adiciona teste para conversor pcm5102
2026-11-10 adiciona projeto kicad com esquematico e pcb
2026-11-10 Ignora historico local do KiCad
2026-11-10 ajustes na pcb
2026-11-11 ajustes na pcb e componentes
2026-11-11 adiciona som jetsons (ruim) e sons no app
2026-11-11 conecta ilha gnd que estava solta
2026-11-11 ajusta footprints e trilhas na pcb
